mflamer/GA144-watch/image.jpg

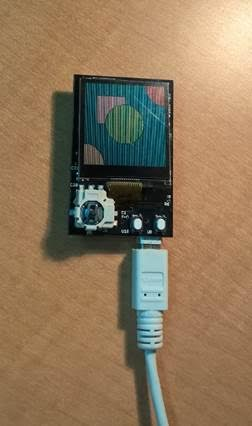
image.jpg
