mflamer/GA144-watch/board/notes.txt

USB caps
LCD VCC should be 5v
Reset pads
Flash cap 
Flash 1.8v pour
