mflamer/GA144-watch/board/board0.2.png

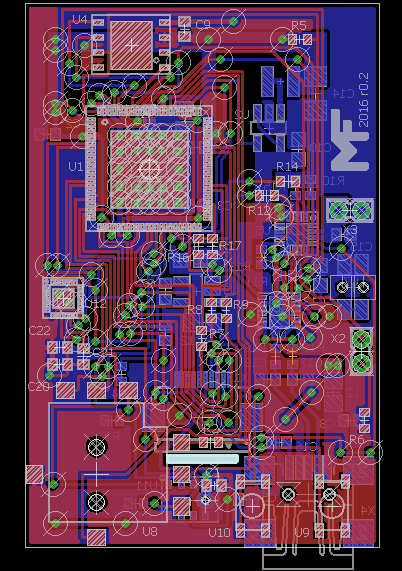
board/board0.2.png
