mflamer/GA144-watch/board/eagle/BOM watch.xlsx

BILL OF MATERIALS
ENTER Project Name , Version #
# | Designator | Quantity | Value | Footprint | Digi-Key (cut tape) (http://www.digikey.com/) | Manufacturer Part Number | Comments
1 | C1,C9,C15 | 3 | 1uf | 0402 | 490-1320-1-ND (http://www.digikey.com/scripts/DkSearch/dksus.dll?Detail&itemSeq=185803933&uq=635867657228176604) | GRM155R60J105KE19D
2 | C2,C3,C4,C5,C6,C7,C19,C20,C21 | 9 | 0.1uf | 0402 | 1276-1443-1-ND (http://www.digikey.com/scripts/DkSearch/dksus.dll?Detail&itemSeq=186568568&uq=635867660433678615) | CL05A104MP5NNNC
3 | C8,C16,C22 | 3 | 0.01uf | 0402 | 490-4516-1-ND (http://www.digikey.com/scripts/DkSearch/dksus.dll?Detail&itemSeq=186265146&uq=635867661613256604) | GRM155R71H103KA88D
4 | C10,C13 | 2 | 4.7uf | 0603 | 1276-2087-1-ND (http://www.digikey.com/scripts/DkSearch/dksus.dll?Detail&itemSeq=185991197&uq=635867674288006604) | CL10B475KQ8NQNC
5 | C11 | 1 | 3.3uf | 0603 | 445-7476-1-ND (http://www.digikey.com/scripts/DkSearch/dksus.dll?Detail&itemSeq=185774680&uq=635867674287996604) | C1608X5R1C335K080AC
6 | C12 | 1 | 6.8uf | 0805 | 399-3136-1-ND (http://www.digikey.com/scripts/DkSearch/dksus.dll?Detail&itemSeq=186569075&uq=635867685191214121) | C0805C685K9PACTU
7 | C14 | 1 | 100uf | 1206 | 490-7217-1-ND (http://www.digikey.com/scripts/DkSearch/dksus.dll?Detail&itemSeq=186246628&uq=635867685191104110) | GRM31CR60J107ME39K
8 | C17,C18 | 2 | 47pf | 0402 | 478-1078-1-ND (http://www.digikey.com/scripts/DkSearch/dksus.dll?Detail&itemSeq=186172403&uq=635867685191084108) | 04025A470JAT2A
9 | U12 | 1 | ACCEL&GYRO | 24QFN | 1428-1011-1-ND (http://www.digikey.com/scripts/DkSearch/dksus.dll?Detail&itemSeq=186264361&uq=635867685191124112) | MPU-6500
10 | Q1 | 1 | 32.768khz | 2-SMD | 535-10247-1-ND (http://www.digikey.com/scripts/DkSearch/dksus.dll?Detail&itemSeq=185792287&uq=635867685190904090) | ABS06-32.768KHZ-9-1-T
11 | R1,R3 | 2 | 14k | 0402 | 311-14.0KLRCT-ND (http://www.digikey.com/scripts/DkSearch/dksus.dll?Detail&itemSeq=185903650&uq=635867685190994099) | RC0402FR-0714KL
12 | R2,R4 | 2 | 7.5k | 0402 | 311-7.50KLRCT-ND (http://www.digikey.com/scripts/DkSearch/dksus.dll?Detail&itemSeq=185903409&uq=635867685190984098) | RC0402FR-077K5L
13 | R5,R10,R11,R13 | 4 | 10k | 0402 | 311-10KJRCT-ND (http://www.digikey.com/scripts/DkSearch/dksus.dll?Detail&itemSeq=186569249&uq=635867694251070016) | RC0402FR-077K5L
14 | R6,R7,R8,R9,R12,R14 | 6 | 1k | 0402 | 311-1.00KLRCT-ND (http://www.digikey.com/scripts/DkSearch/dksus.dll?Detail&itemSeq=186569261&uq=635867695372048053) | RC0402FR-071KL
15 | R15 | 1 | 2.4k | 0402 | 311-2.4KJRCT-ND (http://www.digikey.com/scripts/DkSearch/dksus.dll?Detail&itemSeq=186162614&uq=635867695371988047) | RC0402JR-072K4L
16 | R16 | 1 | 100k | 0402 | 311-100KLRCT-ND (http://www.digikey.com/scripts/DkSearch/dksus.dll?Detail&itemSeq=186468135&uq=635867695372028051) | RC0402FR-07100KL
17 | R17 | 1 | 40.2k | 0402 | RMCF0402FT40K2CT-ND (http://www.digikey.com/scripts/DkSearch/dksus.dll?Detail&itemSeq=186468389&uq=635867695372028051) | RMCF0402FT40K2
18 | U1 | 1 | MCU | QFN88-0.4MM | N/A | GA144-1.20 | http://www.greenarraychips.com/home/products/index.html
19 | U2 | 1 | Stepdown | TSOT23 | LTC3406ES5#TRMPBFCT-ND (http://www.digikey.com/scripts/DkSearch/dksus.dll?Detail&itemSeq=185791531&uq=635867695371938042) | LTC3406ES5#TRMPBF
20 | U3 | 1 | Booster | TSOT23 | LTC1517CS5-5#TRMPBFCT-ND (http://www.digikey.com/scripts/DkSearch/dksus.dll?Detail&itemSeq=185774226&uq=635867695371938042) | LTC1517CS5-5#TRMPBF
21 | U4 | 1 | 128MB FLASH | 8-WSON | 706-1406-ND (http://www.digikey.com/scripts/DkSearch/dksus.dll?Detail&itemSeq=186569403&uq=635867706145556604) | IS25LP128-JKLE
22 | U5 | 1 | Charger | 16QFN | ISL9230IRZ-TCT-ND (http://www.digikey.com/scripts/DkSearch/dksus.dll?Detail&itemSeq=186085435&uq=635867706145496604) | ISL9230IRZ-T
23 | U6 | 1 | USB-UART | 12-DFN | 768-1178-1-ND (http://www.digikey.com/scripts/DkSearch/dksus.dll?Detail&itemSeq=186169829&uq=635867706145506604) | FT234XD-R
24 | L1 | 1 | 4.7uh | 1210 | 490-6619-1-ND (http://www.digikey.com/scripts/DkSearch/dksus.dll?Detail&itemSeq=185775354&uq=635867706145456604) | LQH32CN4R7M33L
25 | U7 | 1 | Button Right Angle | SM | CKN10514CT-ND (http://www.digikey.com/scripts/DkSearch/dksus.dll?Detail&itemSeq=185792767&uq=635867713003186604) | PTS840 GKP SMTR LFS
26 | U8 | 1 | Joystick | SM | 254SA103B50B-ND (http://www.digikey.com/scripts/DkSearch/dksus.dll?Detail&itemSeq=186569521&uq=635867713003466604) | 254SA103B50B
27 | U9,U10 | 2 | Button Top | SM | CKN10503CT-ND (http://www.digikey.com/scripts/DkSearch/dksus.dll?Detail&itemSeq=185805657&uq=635867713003226604) | PTS810 SJK 250 SMTR LFS
28 | L2 | 1 | Ferrite Chip | 0805 | 240-2390-1-ND (http://www.digikey.com/scripts/DkSearch/dksus.dll?Detail&itemSeq=186169798&uq=635867713003296604) | MI0805K601R-10
29 | U11 | 1 | Mic | SM | 1428-1014-1-ND (http://www.digikey.com/scripts/DkSearch/dksus.dll?Detail&itemSeq=186264379&uq=635867713003356604) | INMP441ACEZ-R7
30 | X1 | 1 | FPC Conn 10 | SM | WM7978CT-ND (http://www.digikey.com/scripts/DkSearch/dksus.dll?Detail&itemSeq=185799439&uq=635867713003206604) | 0527461071
31 | X2 | 1 | 2mm Header | Male | S5800-02-ND (http://www.digikey.com/scripts/DkSearch/dksus.dll?Detail&itemSeq=185911508&uq=635867713003256604) | NRPN021PAEN-RC
33 | X4 | 1 | USB MINI B |  | H2959CT-ND (http://www.digikey.com/scripts/DkSearch/dksus.dll?Detail&itemSeq=186171070&uq=635867713003316604) | UX60-MB-5ST
36
38
39
40
41
42
43
44
45
46
47
48
49
50
51
52
53
54
55
56
57
58
59
60
61
62
63
64
65
66
67
68
69
70
71
72
73
74
75
76
77
78
79
80
81
82
83
84
85
86
87
88
89
90
91
92
93
94
95
96
97
98
99
100
101
102
103
104
105
106
107
108
109
110
111
112
113
114
115
116
117
118
119
120
121
122
123
124
125
126
127
128
129
130
131
132
133
134
135
136
137
138
139
140
141
142
143
144
145
