mflamer/GA144-watch/board/2layer.brd.pdf

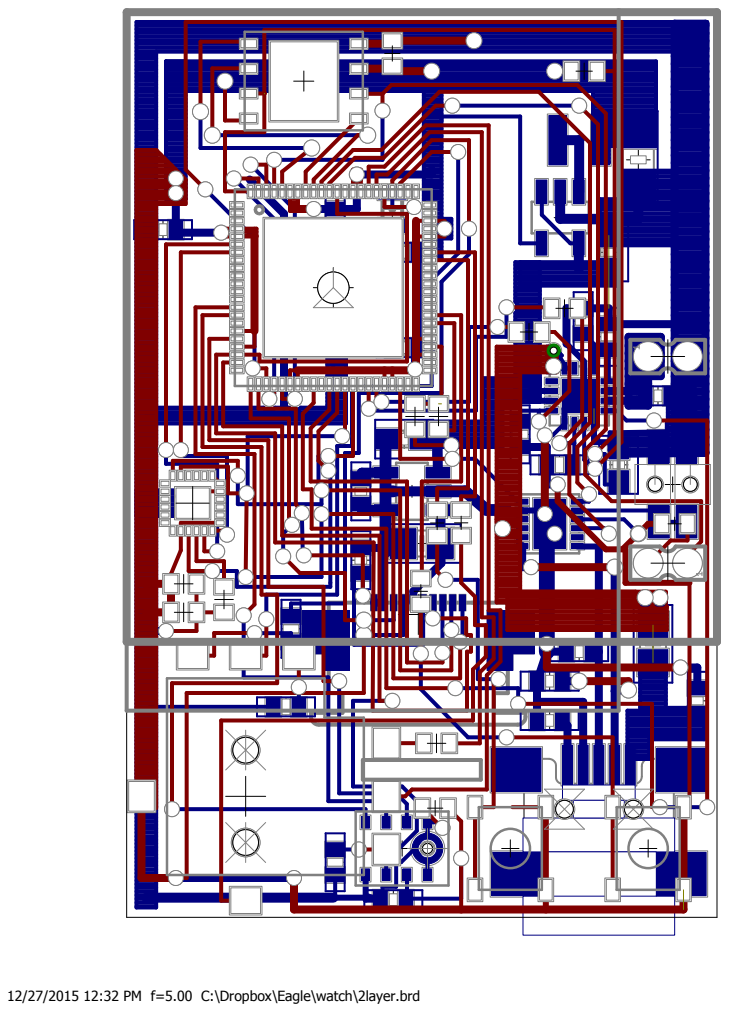
[picture p3: page 1]

12/27/2015 12:32 PM f=5.00 C:\Dropbox\Eagle\watch\2layer.brd
