mflamer/GA144-watch/board/2layer.sch.pdf

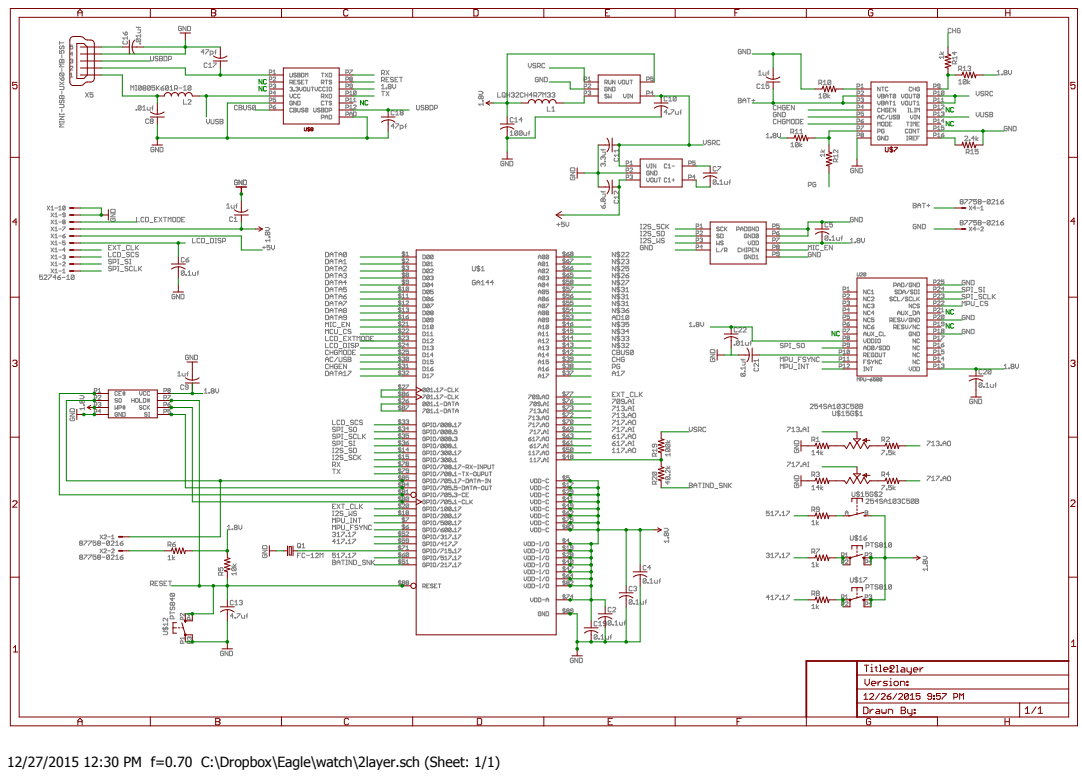
[picture p4: page 1]

12/27/2015 12:30 PM f=0.70 C:\Dropbox\Eagle\watch\2layer.sch (Sheet: 1/1)
