mflamer/GA144-watch/board/eagle/watch.brd

## EAGLE design board/eagle/watch.brd (2017-06-21)

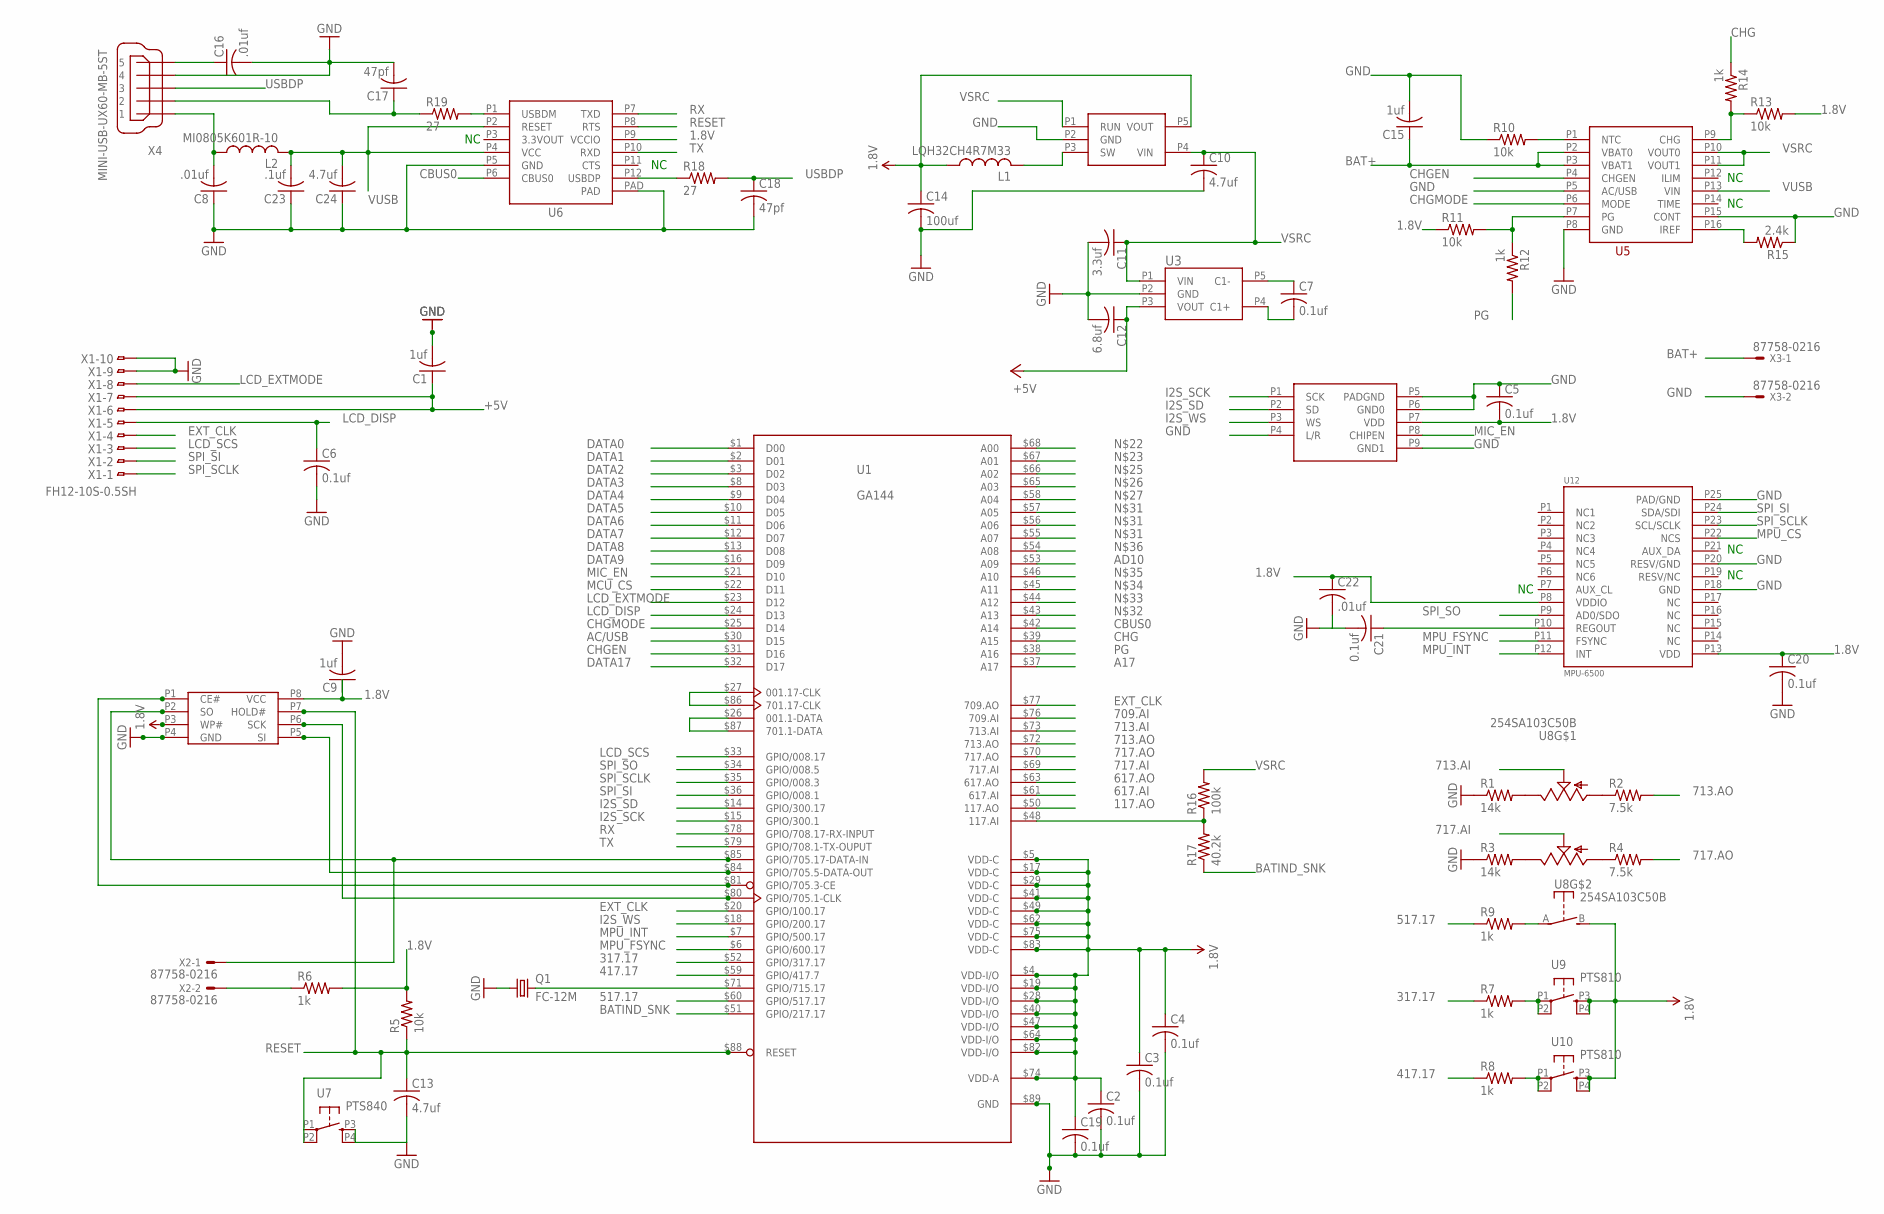
[picture p5: schematic watch.sch]

Parts:
C1, C9, C15: 1uf; C0402
C2, C3, C4, C5, C6, C7, C19, C20, C21: 0.1uf; C0402
C8, C16, C22: .01uf; C0402
C10, C13: 4.7uf; C0603
C11: 3.3uf; C0603
C12: 6.8uf; C0805
C14: 100uf; C1206
C17, C18: 47pf; C0402
C23: .1uf; C0402
C24: 4.7uf; C0402
L1: LQH32CH4R7M33; 1210
L2: MI0805K601R-10; C0805
Q1: FC-12M
R1, R3: 14k; R0402
R2, R4: 7.5k; R0402
R5, R10, R11, R13: 10k; R0402
R6, R7, R8, R9, R12, R14: 1k; R0402
R15: 2.4k; R0402
R16: 100k; R0402
R17: 40.2k; R0402
R18, R19: 27; R0402
U1: GA144; QFN88-0.4MM
U2: LTC3406-1.8; TSOT23
U3: LTC1517-5; TSOT23
U4: IS25WP128-JKLE; WSON8
U5: ISL9230; 16_LD_QFN
U6: FT234XD; DFN-12
U7: PTS840; PTS840GMPSMTRLFS
U8: 254SA103C50B
U9, U10: PTS810
U11: INMP441
U12: MPU-6500; QFN24-3
X1: FH12-10S-0.5SH
X2, X3: 87758-0216
X4: MINI-USB-UX60-MB-5ST; UX60-MB-5ST

Connections:
1.8V: C2.1, C3.1, C4.1, C5.2, C9.1, C14.1, C19.1, C20.1, C22.1, L1.P$1 (1), R5.2, R6.2, R11.1, R13.2, U1.$4 (VDD-I/O), U1.$5 (VDD-C), U1.$17 (VDD-C), U1.$19 (VDD-I/O), U1.$28 (VDD-I/O), U1.$29 (VDD-C), U1.$40 (VDD-I/O), U1.$41 (VDD-C), U1.$47 (VDD-I/O), U1.$49 (VDD-C), U1.$62 (VDD-C), U1.$64 (VDD-I/O), U1.$74 (VDD-A), U1.$75 (VDD-C), U1.$82 (VDD-I/O), U1.$83 (VDD-C), U2.P5 (VOUT), U4.P3 (WP#), U4.P8 (VCC), U6.P9 (VCCIO), U8.B, U9.P3 (S), U9.P4 (S1), U10.P3 (S), U10.P4 (S1), U11.P7 (VDD), U12.P8 (VDDIO), U12.P13 (VDD)
117.AO: U1.$50 (117.AO)
317.17: R7.1, U1.$52 (GPIO/317.17)
417.17: R8.1, U1.$59 (GPIO/417.7)
517.17: R9.1, U1.$60 (GPIO/517.17)
617.AI: U1.$61 (617.AI)
617.AO: U1.$63 (617.AO)
709.AI: U1.$76 (709.AI)
713.AI: U1.$73 (713.AI), U8.P2
713.AO: R2.2, U1.$72 (713.AO)
717.AI: U1.$69 (717.AI), U8.P2'
717.AO: R4.2, U1.$70 (717.AO)
+5V: C1.1, C12.1, U3.P3 (VOUT), X1.6, X1.7
A17: U1.$37 (A17)
AC/USB: U1.$30 (D15)
AD10: U1.$53 (A09)
AUX_CL: U12.P7 (AUX_CL)
AUX_DA: U12.P21 (AUX_DA)
BAT+: C15.1, U5.P2 (VBAT0), U5.P3 (VBAT1), X3.1
BATIND: R16.1, R17.2, U1.$48 (117.AI)
BATIND_SNK: R17.1, U1.$51 (GPIO/217.17)
CBUS0: U1.$42 (A14), U6.P6 (CBUS0)
CHG: R14.1, U1.$39 (A15)
CHGEN: U1.$31 (D16), U5.P4 (CHGEN)
CHGMODE: U1.$25 (D14), U5.P6 (MODE)
DATA0: U1.$1 (D00)
DATA1: U1.$2 (D01)
DATA2: U1.$3 (D02)
DATA3: U1.$8 (D03)
DATA4: U1.$9 (D04)
DATA5: U1.$10 (D05)
DATA6: U1.$11 (D06)
DATA7: U1.$12 (D07)
DATA8: U1.$13 (D08)
DATA9: U1.$16 (D09)
DATA17: U1.$32 (D17)
EXT_CLK: U1.$20 (GPIO/100.17), U1.$77 (709.AO), X1.4
GND: C1.2, C2.2, C3.2, C4.2, C5.1, C6.2, C8.1, C9.2, C10.2, C11.2, C12.2, C13.2, C14.2, C15.2, C16.2, C17.2, C18.2, C19.2, C20.2, C21.2, C22.2, C23.1, C24.1, Q1.1, R1.1, R3.1, R10.1, R15.1, U1.$89 (GND), U2.P2 (GND), U3.P2 (GND), U4.P4 (GND), U5.P5 (AC/USB), U5.P8 (GND), U5.P15 (CONT), U6.P5 (GND), U6.PAD, U7.P3 (S), U7.P4 (S1), U11.P4 (L/R), U11.P5 (PADGND), U11.P6 (GND0), U11.P9 (GND1), U12.P18 (GND), U12.P20 (RESV/GND), U12.P25 (PAD/GND), X1.9, X1.10, X3.2, X4.4
I2S_SCK: U1.$15 (GPIO/300.1), U11.P1 (SCK)
I2S_SD: U1.$14 (GPIO/300.17), U11.P2 (SD)
I2S_WS: U1.$18 (GPIO/200.17), U11.P3 (WS)
LCD_DISP: C6.1, U1.$24 (D13), X1.5
LCD_EXTMODE: U1.$23 (D12), X1.8
LCD_SCS: U1.$33 (GPIO/008.17), X1.3
MCU_CS: U1.$22 (D11)
MIC_EN: U1.$21 (D10), U11.P8 (CHIPEN)
MPU_CS: U12.P22 (NCS)
MPU_FSYNC: U1.$6 (GPIO/600.17), U12.P11 (FSYNC)
MPU_INT: U1.$7 (GPIO/500.17), U12.P12 (INT)
unnamed: R6.1, X2.2
unnamed: C7.1, U3.P5 (C1-)
unnamed: C7.2, U3.P4 (C1+)
unnamed: R10.2, U5.P1 (NTC)
unnamed: U1.$26 (001.1-DATA), U1.$87 (701.1-DATA)
unnamed: U1.$27 (001.17-CLK), U1.$86 (701.17-CLK)
unnamed: L1.P$2 (2), U2.P3 (SW)
unnamed: Q1.2, U1.$71 (GPIO/715.17)
unnamed: U1.$81 (GPIO/705.3-CE), U4.P1 (CE#)
unnamed: U1.$85 (GPIO/705.17-DATA-IN), U4.P2 (SO), X2.1
unnamed: R15.2, U5.P16 (IREF)
unnamed: C21.1, U12.P10 (REGOUT)
unnamed: R11.2, R12.1, U5.P7 (PG)
unnamed: R1.2, U8.P1
unnamed: R2.1, U8.P3
unnamed: R3.2, U8.P1'
unnamed: R4.1, U8.P3'
unnamed: R7.2, U9.P1, U9.P2 (P1)
unnamed: R8.2, U10.P1, U10.P2 (P1)
unnamed: R13.1, R14.2, U5.P9 (CHG)
unnamed: R9.2, U8.A
unnamed: C16.1, X4.5
unnamed: U1.$84 (GPIO/705.5-DATA-OUT), U4.P5 (SI)
PG: R12.2, U1.$38 (A16)
RESET: C13.1, R5.1, U1.$88 (RESET), U4.P7 (HOLD#), U6.P8 (RTS), U7.P1, U7.P2 (P1)
RESV/NC: U12.P19 (RESV/NC)
RX: U1.$78 (GPIO/708.17-RX-INPUT), U6.P7 (TXD)
SCK: U1.$80 (GPIO/705.1-CLK), U4.P6 (SCK)
SPI_SCLK: U1.$35 (GPIO/008.3), U12.P23 (SCL/SCLK), X1.1
SPI_SI: U1.$36 (GPIO/008.1), U12.P24 (SDA/SDI), X1.2
SPI_SO: U1.$34 (GPIO/008.5), U12.P9 (AD0/SDO)
TX: U1.$79 (GPIO/708.1-TX-OUPUT), U6.P10 (RXD)
USBDM: C17.1, R19.1, R19.2, U6.P1 (USBDM), X4.2
USBDP: C18.1, R18.1, R18.2, U6.P12 (USBDP), X4.3
VSRC: C10.1, C11.1, R16.2, U2.P1 (RUN), U2.P4 (VIN), U3.P1 (VIN), U5.P10 (VOUT0), U5.P11 (VOUT1)
VUSB: C8.2, C23.2, C24.2, L2.1, L2.2, U5.P13 (VIN), U6.P2 (RESET), U6.P4 (VCC), X4.1

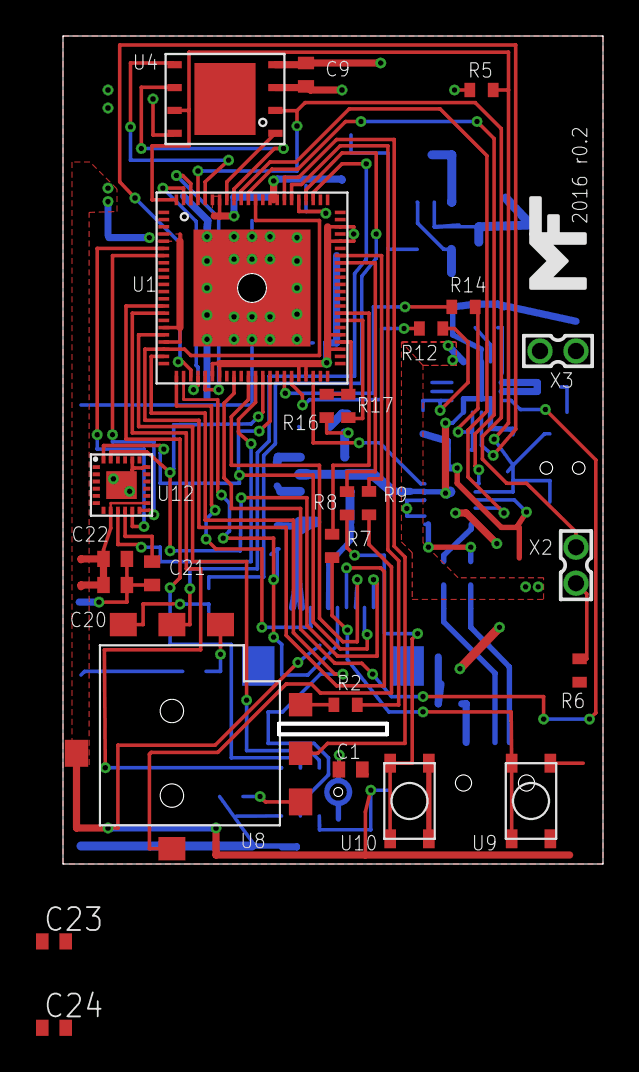
[picture p6: board watch.brd from above]

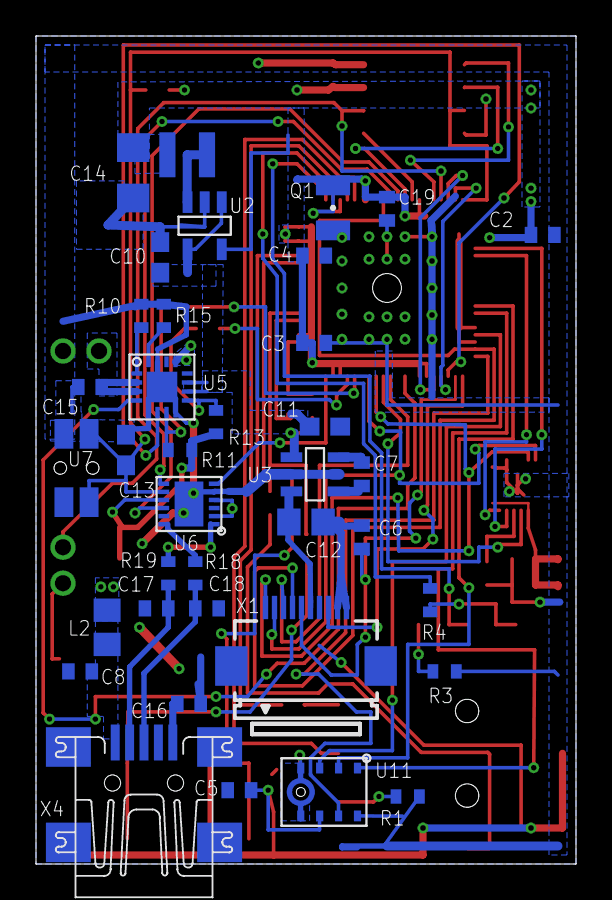
[picture p7: board watch.brd from below]

Board: 2 copper layers, 30.0 x 46.0 mm, 62 parts (37 on the bottom side), 62 nets.
