mflamer/GA144-watch/(threads)

Thread 2 (2017-09-20):

What a brilliant idea

clozinski, 2017-09-20:
Did you know that the mask process used by Green Arrays is from Swatch.?

And battery power matters hugely for a watch.  Talk blue tooth to your cell phone.

I am off to a technical conference in France.  I would love to talk to you by phone when I return.

Chris

mflamer, 2017-09-20:
Hi Chris, ping me when you get back!

clozinski, 2017-09-26:
I am back.  You can reach me this way.
https://pythonlinks.info/contact
Maye clozinski on skype is the best way.

I am in Poland.

mflamer, 2017-09-26:
Hi Chris, what were you interested in discussing? GA144?

Let me know your interests and maybe we can arrange a conversation soon.

Thanks,
Mark Flamer

On Tue, Sep 26, 2017 at 12:32 AM, Christopher Lozinski <
notifications@github.com> wrote:

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

clozinski, 2017-09-26:
What intrigues me is to find a product that requires Forth.

Watch may be it.

So I am curious what your plan is for the watch?  What target market are you interested in?

I took a look at the swatches today.  3 year battery life.  GA144 uses the same fab.

Turns out swatch is releasing a smart watch end of 2018.

I also took a look at the apple watch.  They just released a new version with cellular.  Think Dick Tracy, no iPhone required.
 WOW.

And then swatch has a chip for sensor integration, gps, compass, orientation, pressure, kaman filtering.
100 times less power than the arm solution.

And the other issue is that Poland has lots of money for startups.

So what is your target market?

Warm Regards
Chris

mflamer, 2017-09-27:
Hi Chris. I built a prototype unit last year. Currently myself and 2 others
are writing software with the intent of presenting it at the Hackaday
Superconference in November.

The idea was basically to produce a prototype wearables platform that could
showcase the strengths of the GA144.

Attached is a short presentation we gave at a forth meeting a couple months
ago.

Currently we are just experimenting and don't have a solid roadmap or plan
to go to market. But, that could change if someone wanted to help support
our efforts.....

I'm busy with some family stuff currently. The other guys are pretty active
on this repo lately.

https://github.com/jamesbowman/ga144tools

Thanks for reaching out,
Mark Flamer

On Tue, Sep 26, 2017 at 1:06 PM, Christopher Lozinski <
notifications@github.com> wrote:

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

clozinski, 2017-09-27:
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
Thank you for the pointer.  I followed that repository.

I did not see any attachment in my email, nor on GitHub.  Can you be so kind as to repost it, or just email it to me.
lozinski@blogory.org <mailto:lozinski@blogory.org>

Warm Regards
Chris
