mflamer/GA144-watch/(commit log)

2017-06-21 create repo
    [ADMP401-Breakout-v13.sch, BOM watch.xlsx, watch centroid.csv, watch.brd, watch.sch]
2017-06-23 local copy of Bowman tool chain
2017-10-12 better display ram wire
2017-10-27 fix empty update case
2017-10-29 move wire nodes from nt.ga to watch.ga
2017-10-29 support for reading buttons
2018-11-20 add BOM
    [digikey-BOM.csv]
